MOSH-Insa-Toulouse/2021-2022_Karmoudi_Bahaj/Images_Capteur/PCB_3D_2.png

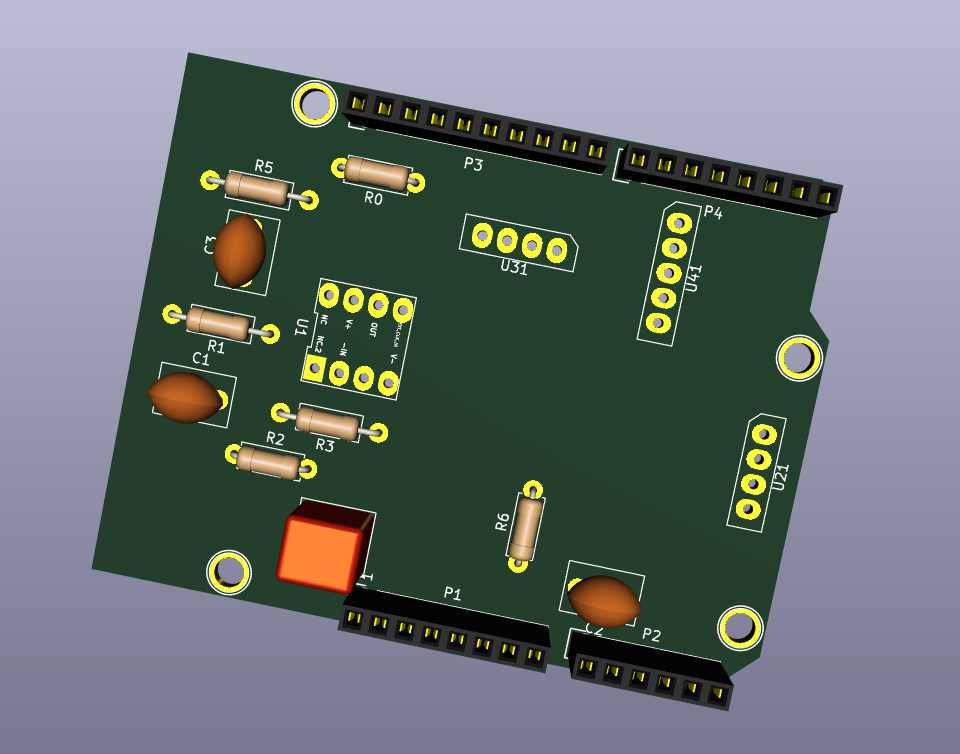
Images_Capteur/PCB_3D_2.png
