MOSH-Insa-Toulouse/2021-2022_Karmoudi_Bahaj/LTspice.pdf

Bahaj Fatima Ezzahra
Karmoudi Imane

## Simulation du capteur avec LtSpice

Dans ce projet, nous utilisons un capteur de conductance très faible de l’ordre de la dizaine de nS et qui est alimenté d’une tension continue de 5V pour une variation de résistance entre 20M et 500M ohm très supérieure à l’impédance de l’Arduino. Ainsi, afin d’extraire l’information utile du capteur on amplifie le signal avec un montage amplificateur trans-impédance représenté ci-dessus :

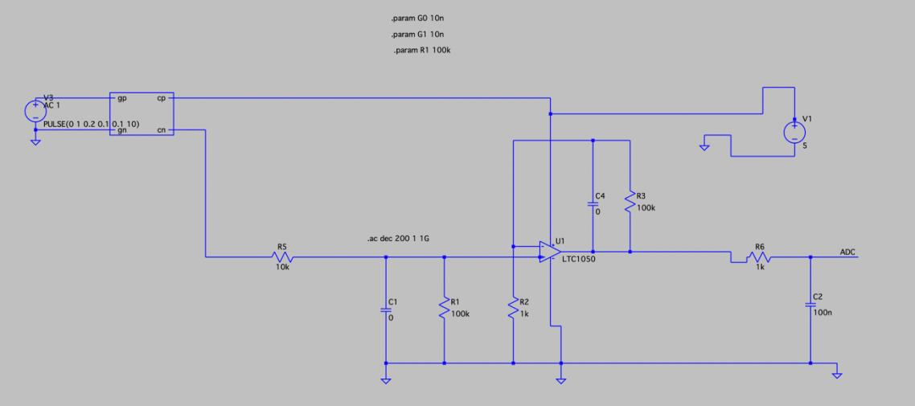
[picture p2: figure]

En rajoutant une source de bruit à 50Hz, le montage permet à la fois d’amplifier et filtrer le signal grâce à 3 filtres en tension et un filtre en courant :

Figure 1: Montage Amplificateur Trans-impédance

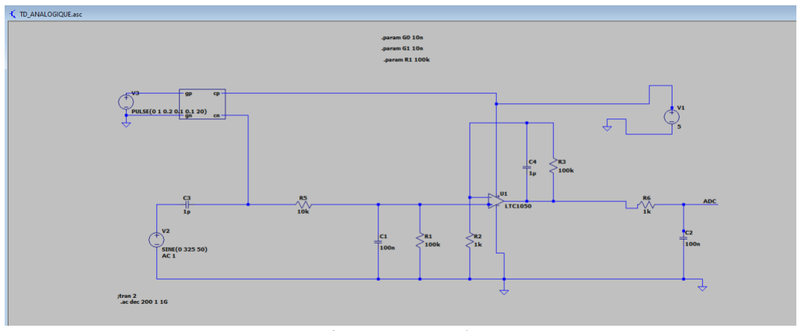
[picture p3: figure]

Figure 2: Montage Amplificateur Trans-impédance avec bruit de 50 Hz

- R5 en entrée protège l’AOP contre les décharges électrostatiques et forme avec C1 un filtre pour les bruits en tension.
- C1 avec R1 forme un filtre pour le bruit en courant.
- C4 avec R3 forme un filtre actif.
- C2 avec R6 forme le filtre de sortie.
- C3 filtre le bruit d'alimentation.

À l’aide d’une simulation on retrouve les fréquences de coupure de chaque filtre :

Fréquence de coupure de l’étage droite (R6C2) : f2 = 1.6 kHz

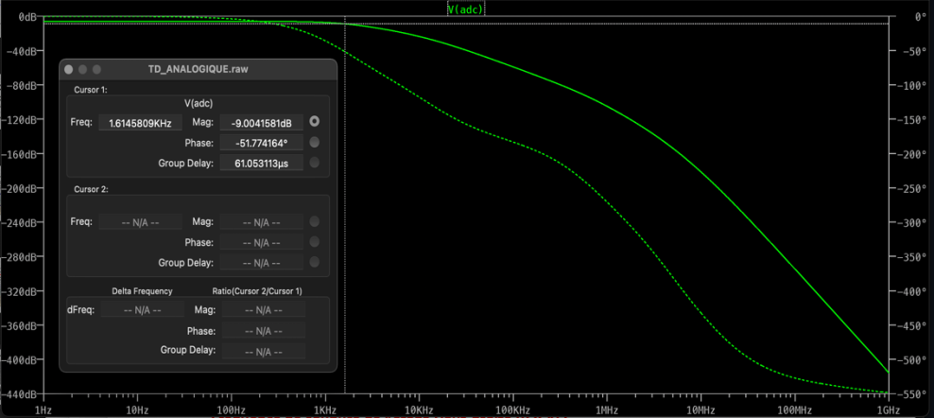
[picture p4: figure]

Fréquence de coupure de l’étage Haut-droite (R3C4) : f3 = 2 Hz

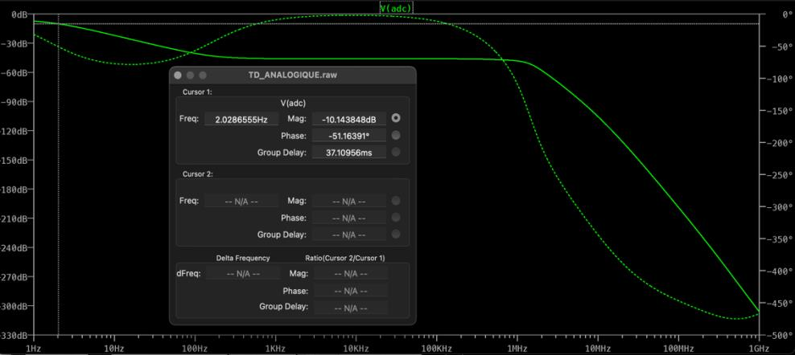
[picture p5: figure]
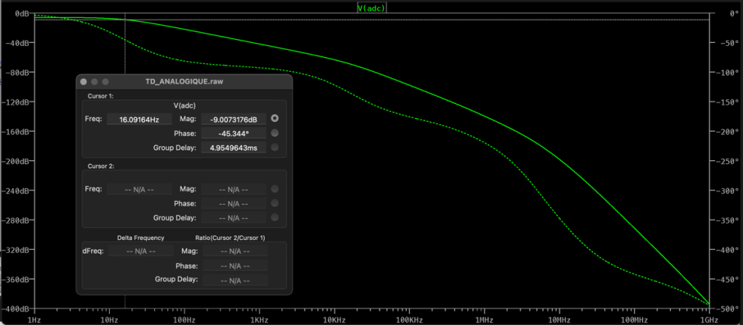
[picture p6: figure]

Fréquence de coupure de l’étage gauche(R1C1) : f1 = 16 Hz

On peut aussi voir la réponse de Vadc en fonction du temps qui démontre que le capteur est bien fonctionnel puisque la réponse suit le pulse qui varie entre 0 et 1V et ne sature pas. En effet, le plateau est bien inférieur à 5V.

Signal sans influence du bruit 50Hz

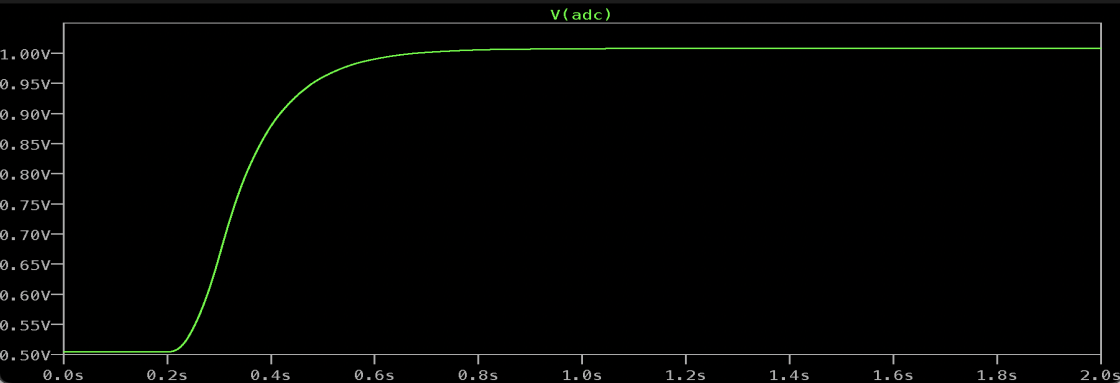
[picture p7: figure]

Signal avec influence du bruit 50Hz

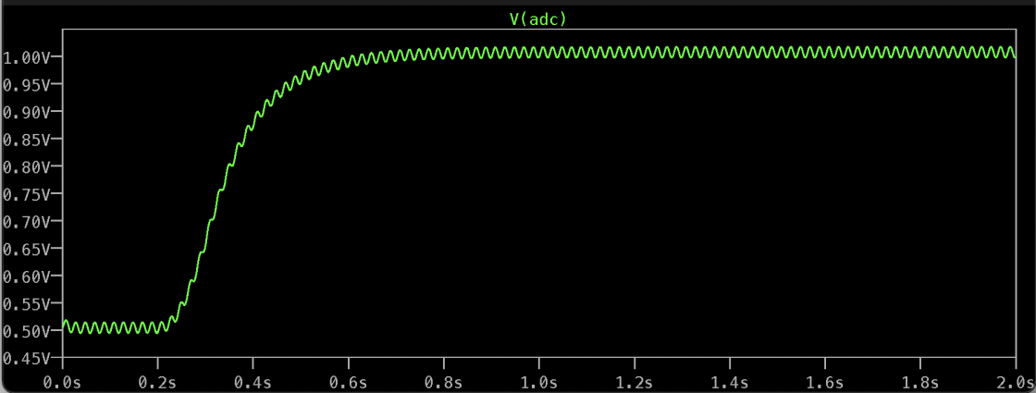
[picture p8: figure]

Incidence de l’offset de l’amplificateur LTC1050

La datasheet du LTC1050 nous indique que l’offset d’entrée de l’AOP a pour valeur 0.5µV et son gain est de l’ordre de 160 dB. On aura donc comme tension de sortie 10⁶ V pour une tension d’entrée qui vaut 10mV. Cependant, l’offset de sortie de l’AOP est de 50V ainsi l’offset est négligeable et son incidence est acceptable.

Incidence du courant d’entrée de l’amplificateur LTC1050 :

En faisant varier les paramètres G0 et G1 de la source de courant variable BI, on fait varier le Isens afin de retrouver la valeur pour laquelle on aura une saturation. A l’aide de la simulation on retrouve que la saturation en sortie vaut 4.8V pour Isens = 480 nA.

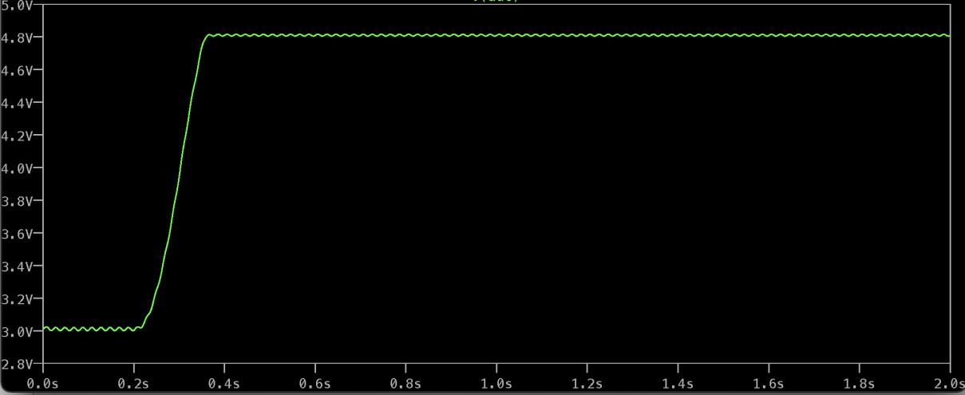
[picture p9: figure]

Atténuation globale d’un bruit de 50 Hz

À l’aide de la simulation LTspice, nous obtenons la courbe du gain en fonction de la fréquence ci-dessous :à

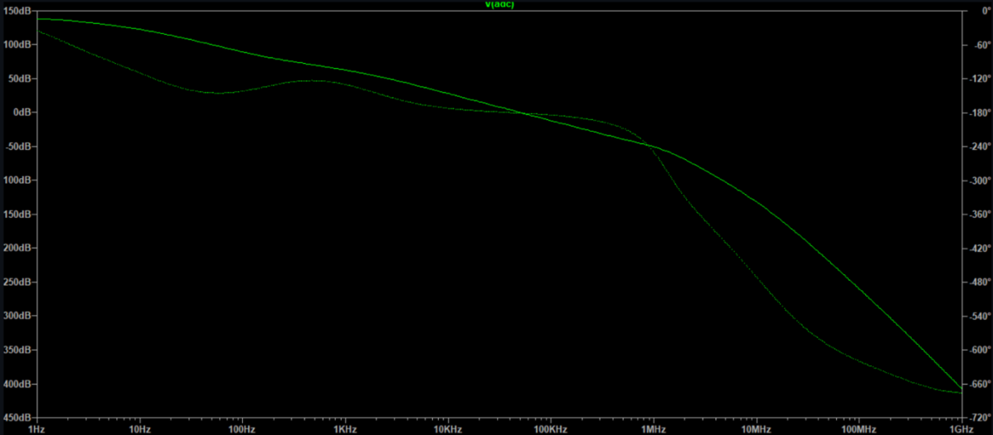
[picture p10: figure]

On obtient pour un bruit de 50Hz une atténuation de 140 -100= 40 dB.

Atténuation globale d’un bruit en courant à la fréquence limite de repliement dans le cas de L’ADC Arduino Uno :

Pour ne pas avoir une perte de qualité, nous faisons fonctionner ADC à la plus grande fréquence utilisable, dans le cas de l’Arduino Uno, cette fréquence est égale à 200kHz/13= 15.4kHz. La fréquence de Nyquist (limite de repliement) correspond à la moitié de la fréquence

Figure 3 : Saturation du capteur pour un courant de 480 nA

Figure 4: Courbe du Gain en fonction de la fréquence d’échantillonnage. Dans notre cas ici, la fréquence d’échantillonnage est égale à 15 kHz, ce qui donne une fréquence de Nyquist qui veut 7.5kHz. D’après la simulation on trouve que pour fNyquist= 7.5kHz on a un gain de 33dB. Ainsi on a une atténuation de 140-33= 107 dB.

Expression analytique de la résistance du capteur en fonction des éléments du circuit trans-impédance :

Rcapteur= (1 + R3
R2

) * R1* Vcc
VADC

– R1 – R5

Avec : R5 = 10 kΩ | R1 = 100 kΩ | R2 = 1 kΩ | R3 = 100 kΩ
