MOSH-Insa-Toulouse/2021-2022_Karmoudi_Bahaj/Application/Connexion_BT.png

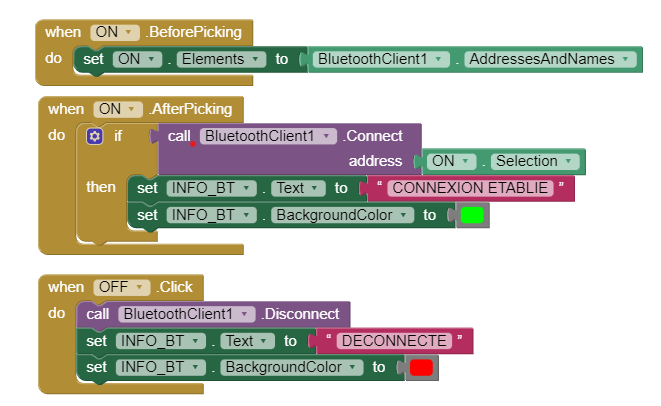
Application/Connexion_BT.png
