MOSH-Insa-Toulouse/2021-2022_Karmoudi_Bahaj/Application/Graphe_APK.png

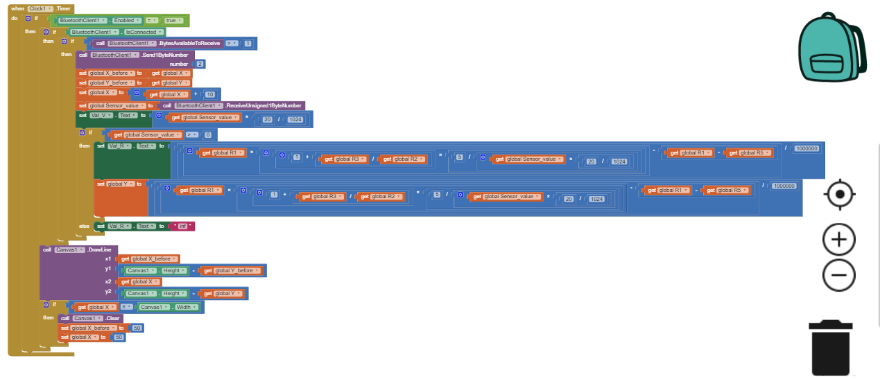
Application/Graphe_APK.png
