MOSH-Insa-Toulouse/2021-2022_Karmoudi_Bahaj/Application/Interface_APK.png

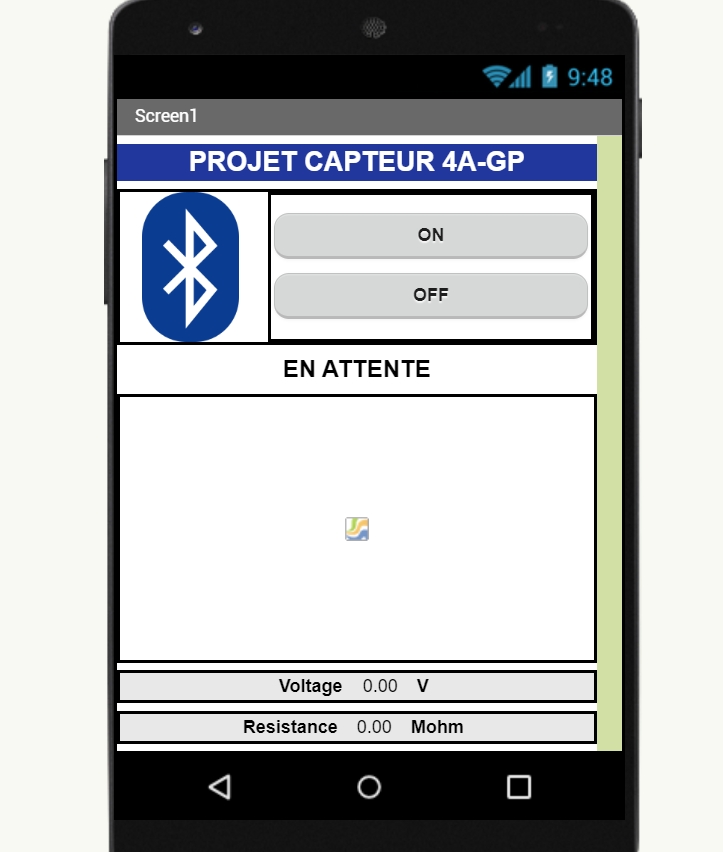
Application/Interface_APK.png
