MOSH-Insa-Toulouse/2021-2022_Karmoudi_Bahaj/Application/Variables_APK.png

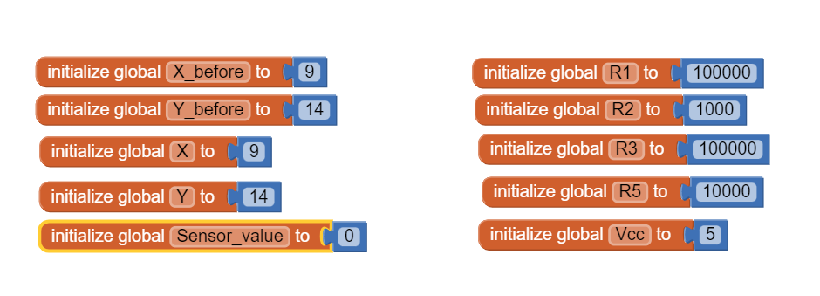
Application/Variables_APK.png
