MOSH-Insa-Toulouse/2021-2022_Karmoudi_Bahaj/Images_Capteur/Bluetooth.png

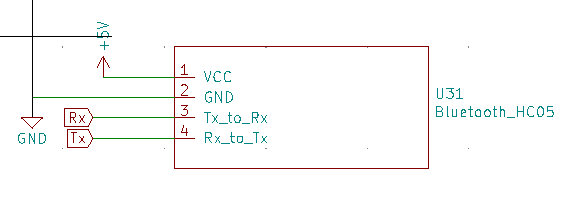
Images_Capteur/Bluetooth.png
