MOSH-Insa-Toulouse/2021-2022_Karmoudi_Bahaj/Images_Capteur/Bluetooth_empreinte.png

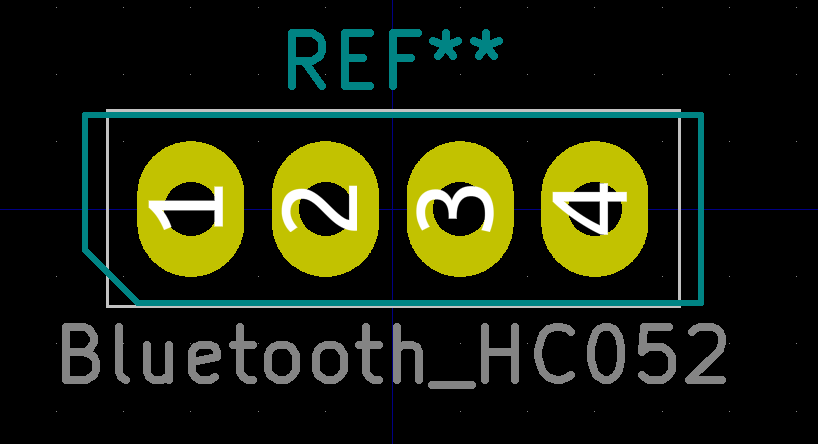
Images_Capteur/Bluetooth_empreinte.png
