MOSH-Insa-Toulouse/2021-2022_Karmoudi_Bahaj/Images_Capteur/Circuit_Global.png

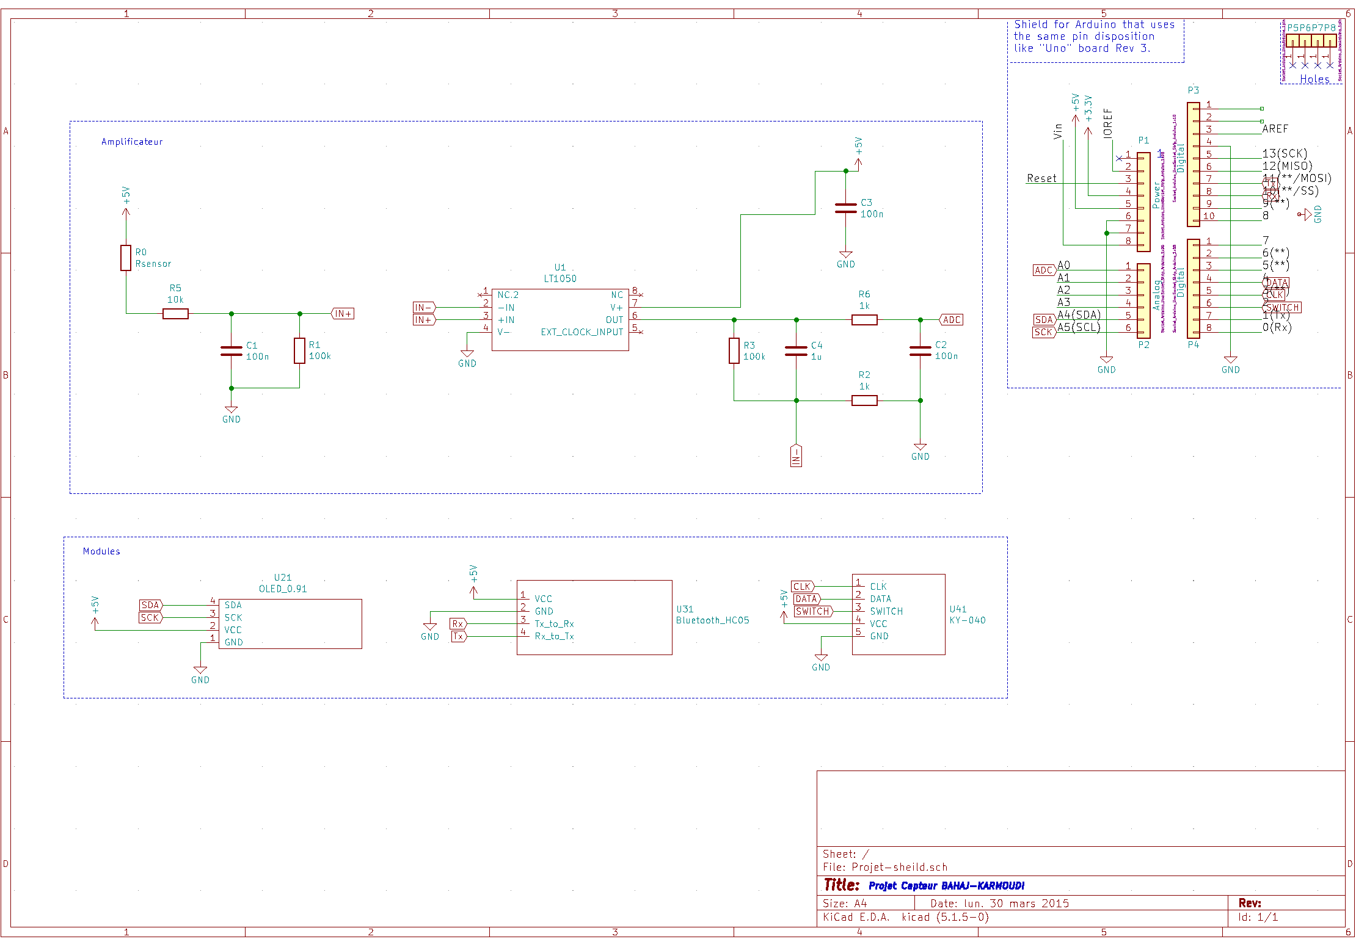
Images_Capteur/Circuit_Global.png
