MOSH-Insa-Toulouse/2021-2022_Karmoudi_Bahaj/Images_Capteur/Encodeur.png

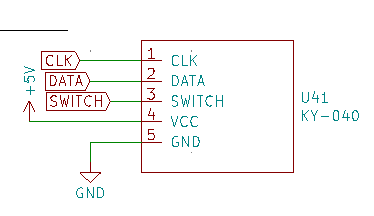
Images_Capteur/Encodeur.png
