MOSH-Insa-Toulouse/2021-2022_Karmoudi_Bahaj/Images_Capteur/Encodeur_empreinte.png

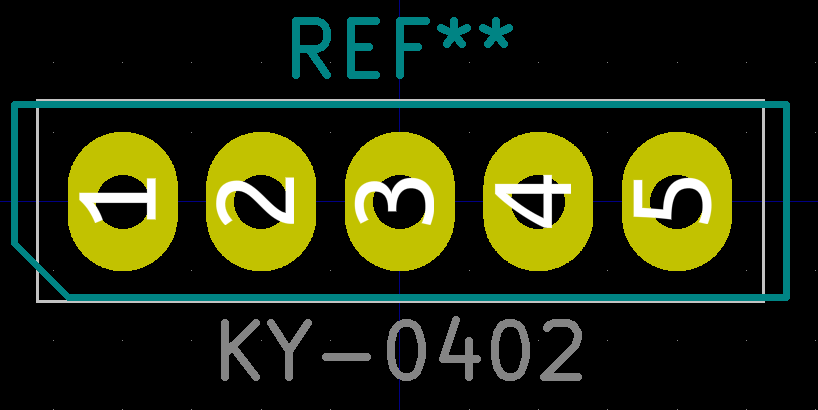
Images_Capteur/Encodeur_empreinte.png
