MOSH-Insa-Toulouse/2021-2022_Karmoudi_Bahaj/Images_Capteur/LT1050_empreinte.png

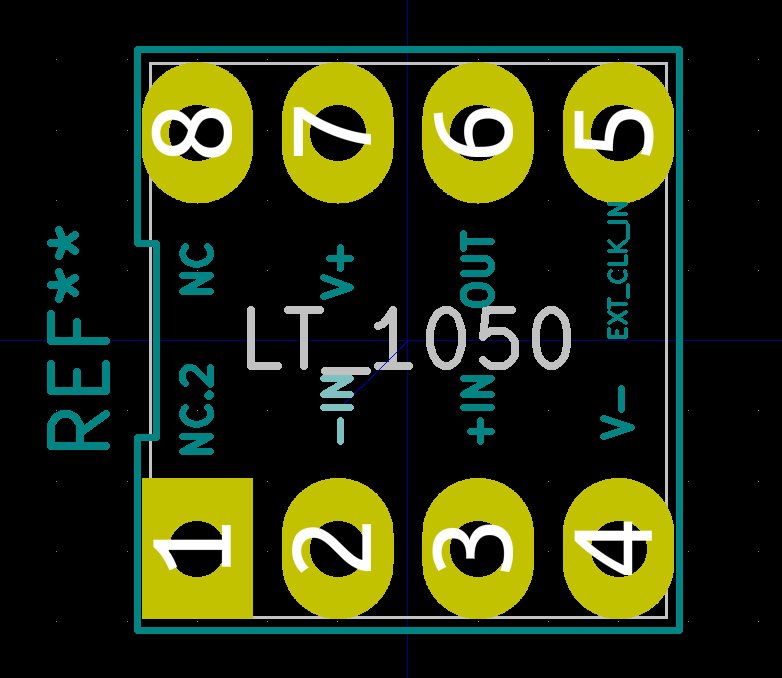
Images_Capteur/LT1050_empreinte.png
