MOSH-Insa-Toulouse/2021-2022_Karmoudi_Bahaj/Images_Capteur/OLED.png

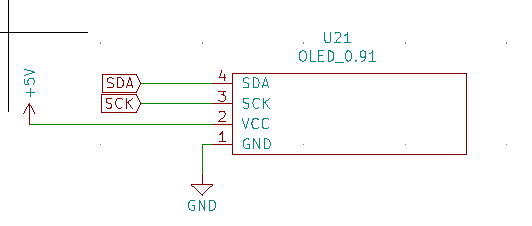
Images_Capteur/OLED.png
