MOSH-Insa-Toulouse/2021-2022_Karmoudi_Bahaj/Images_Capteur/OLED_empreinte.png

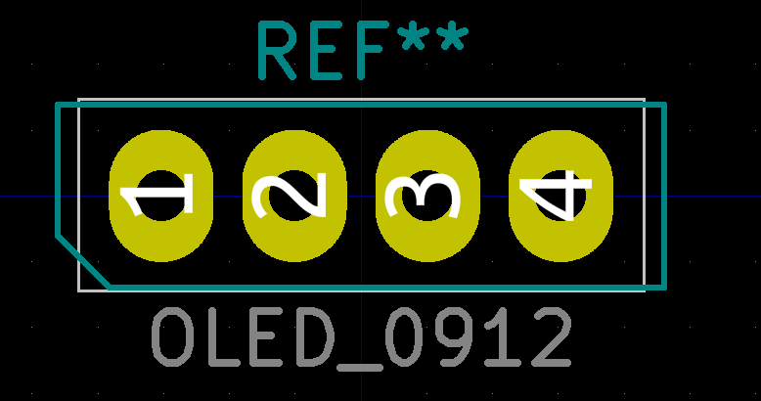
Images_Capteur/OLED_empreinte.png
