MOSH-Insa-Toulouse/2021-2022_Karmoudi_Bahaj/Images_Capteur/PCB.png

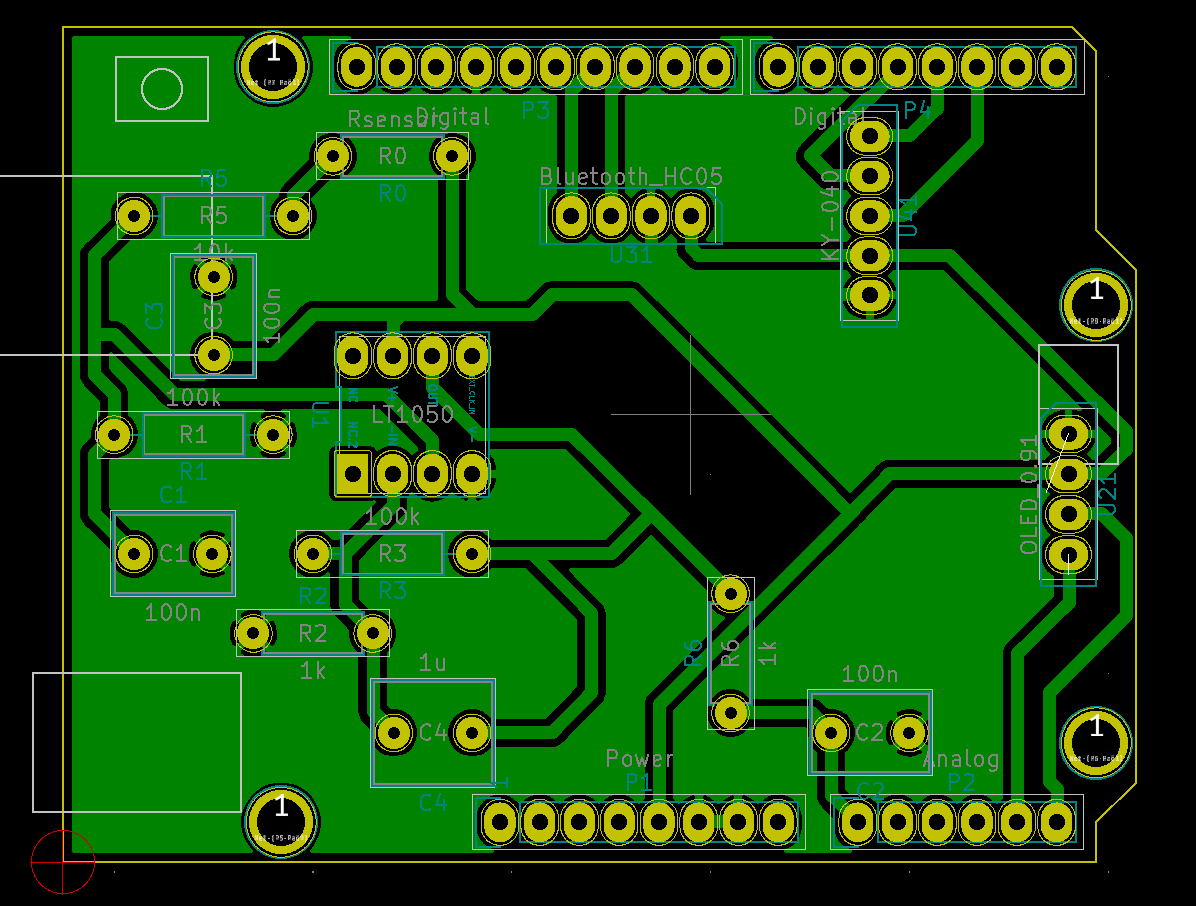
Images_Capteur/PCB.png
