MOSH-Insa-Toulouse/2021-2022_Karmoudi_Bahaj/Banc de test/Résultat_Banc_Test.xlsx

COMPRESSION |  |  |  |  |  |  | TENSION
B |  |  |  |  |  |  | B
Rayon de courbure(cm) | Résistance Mohm | DeltaR | DeltaR/R0 | % | Déformation | % | Rayon de courbure(cm) | Résistance Mohm | DeltaR | DeltaR/R0 | % | Déformation | %
0 | 61.5 | 0 | 0 | 0 | 0 | 0 | 0 | 93.5 | 0 | 0 | 0 | 0 | 0
1.5 | 52.6 | -8.9 | -0.1447154472 | -14.47154472 | 0.0225 | 2.25 | 1.5 | 102.3 | 8.8 | 0.09411764706 | 9.411764706 | 0.0225 | 2.25
2 | 50.8 | -10.7 | -0.1739837398 | -17.39837398 | 0.03 | 3 | 2 | 103.3 | 9.8 | 0.1048128342 | 10.48128342 | 0.03 | 3
2.5 | 49.5 | -12 | -0.1951219512 | -19.51219512 | 0.0375 | 3.75 | 2.5 | 106.5 | 13 | 0.1390374332 | 13.90374332 | 0.0375 | 3.75
3 | 46.1 | -15.4 | -0.2504065041 | -25.04065041 | 0.045 | 4.5 | 3 | 108.8 | 15.3 | 0.1636363636 | 16.36363636 | 0.045 | 4.5
6B |  |  |  |  |  |  | 6B
0 | 42.6 | 0 | 0 | 0 | 0 | 0 | 0 | 40.1 | 0 | 0 | 0 | 0 | 0
1.5 | 40.6 | -2 | -0.04694835681 | -4.694835681 | 0.0225 | 2.25 | 1.5 | 46.1 | 6 | 0.1496259352 | 14.96259352 | 0.0225 | 2.25
2 | 39.4 | -3.2 | -0.07511737089 | -7.511737089 | 0.03 | 3 | 2 | 47.6 | 7.5 | 0.187032419 | 18.7032419 | 0.03 | 3
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
